TheMindVirus/reduino/firmware/umbilical.png

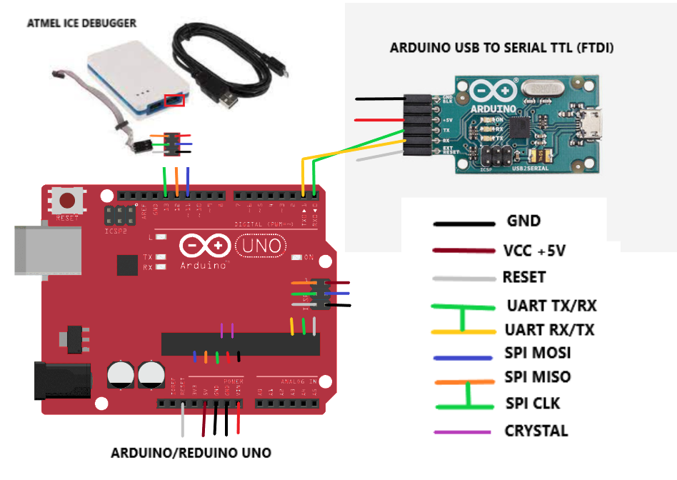
firmware/umbilical.png
